jbeuckm/Roland-140-EG/roland_140_eg.dxf

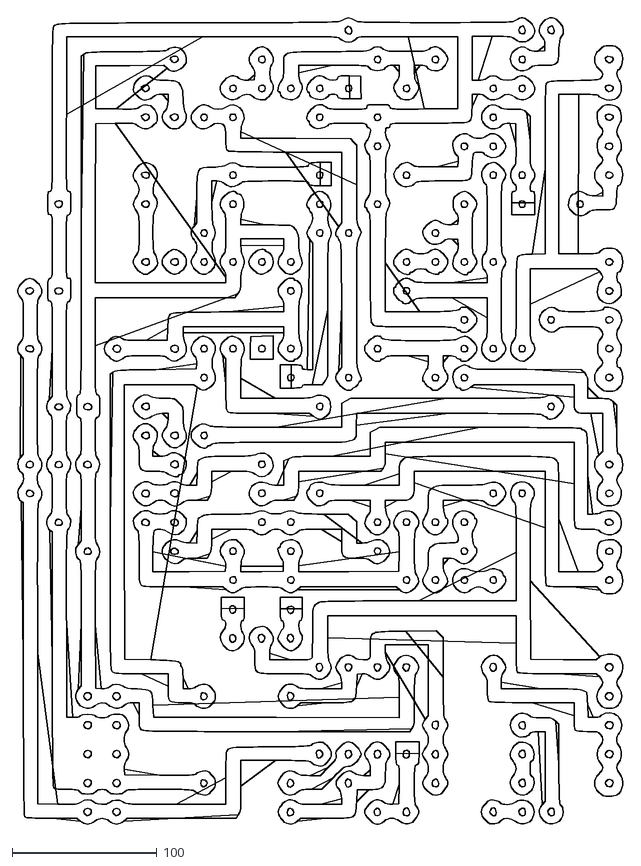
[picture p1: CAD file, 2015-08-30]
roland_140_eg.dxf
421.0 x 560.2
