jbeuckm/Roland-140-EG/panel/140_eg_panel.pdf

# ADSR

# gate

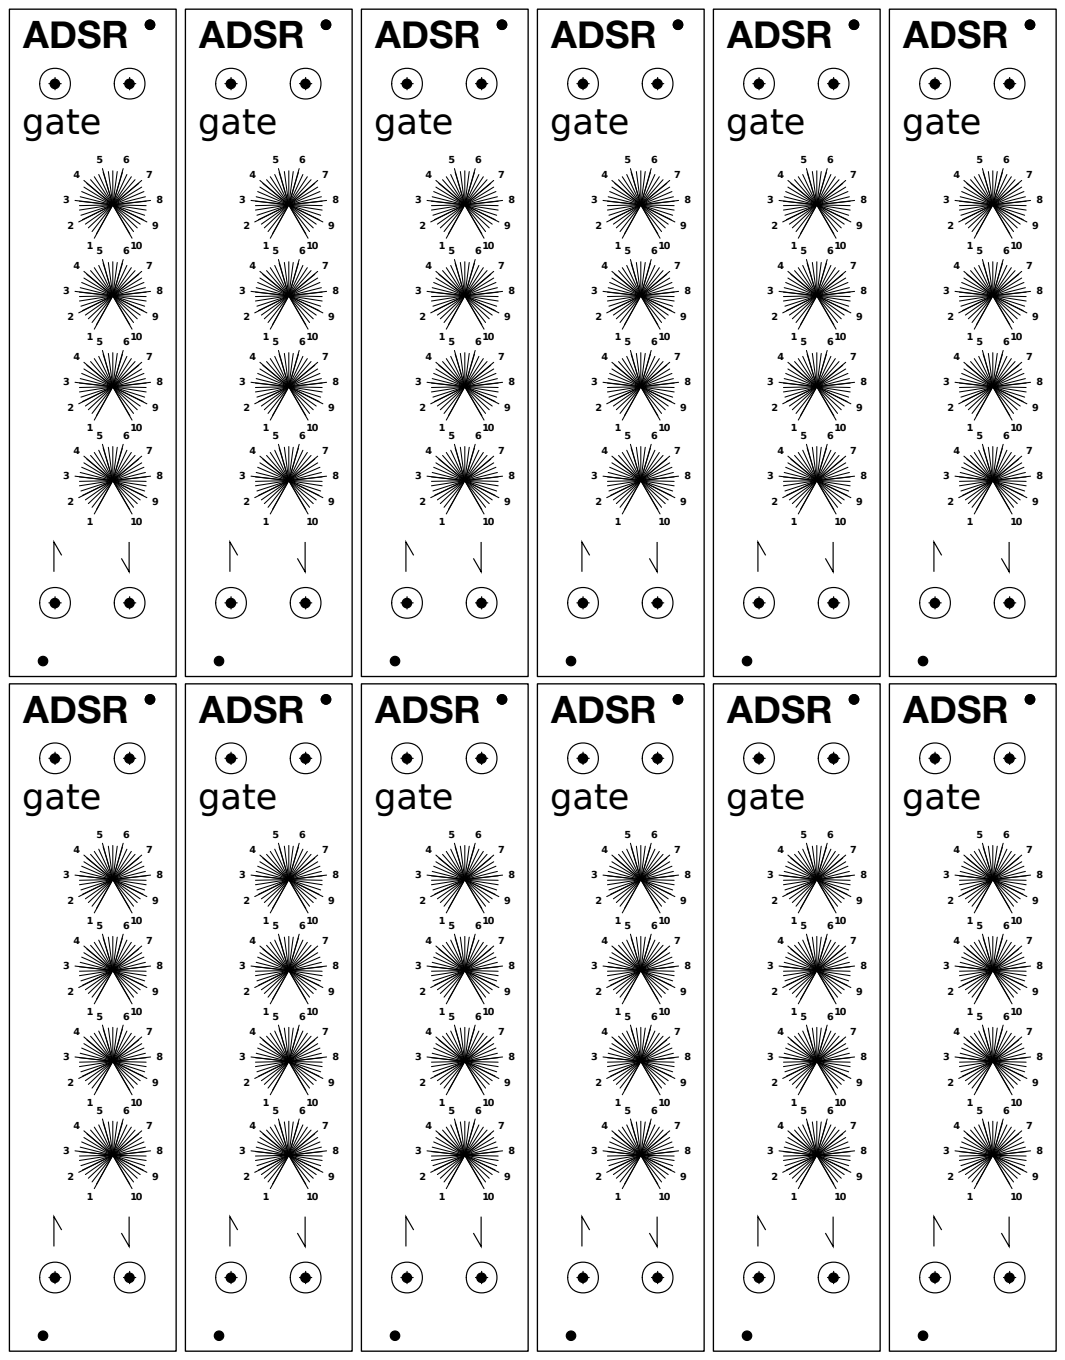
[picture p2: page 1]
ADSR; gate
